i-ahmads/dual-sensor-seismic-alert-system/README.md

# Dual-Sensor Seismic Alert System

A prototype that combines a piezoelectric vibration sensor and an MPU-6050 accelerometer to trigger a local audible and visual alert. The project includes a breadboard firmware implementation, a separate FFT simulation path, circuit diagrams, Proteus simulation captures, and MATLAB signal analysis.

## Design overview

The intended architecture has a sensing node and an alarm/gateway node. The sensing node conditions the piezo signal, reads the accelerometer, and evaluates sensor agreement; the gateway design provides LEDs and a buzzer. The two PCB layouts were etched and drilled but are **unpopulated**. The demonstrated setup runs on **one breadboarded ESP32** with USB power.

| Path | What it does | Status |
|---|---|---|
| [RMS alarm firmware](firmware/Seismic_RMS_Alarm/Seismic_RMS_Alarm.ino) | Calibrates both sensors, evaluates RMS thresholds within a 500 ms agreement window, and latches the alarm | Breadboard demonstration |
| [FFT simulation firmware](firmware/Seismic_FFT_ProteusSim/Seismic_FFT_ProteusSim.ino) | 256 samples at 100 Hz, Hamming window, bins 3–25; simulated gateway confirmation | Proteus simulation on an Arduino Mega stand-in |
| [MATLAB validation](matlab/Seismic_FFT_Validation.m) | Compares in-band energy across earthquake and nuisance-vibration examples | Analysis script; original earthquake input file is not included |
| Two-node ESP-NOW and external event-feed cross-check | Communication and second-stage confirmation | Planned; not demonstrated |

### Hardware

Dual-sensor circuit overview

*Piezo and MPU-6050 sensing arrangement.*

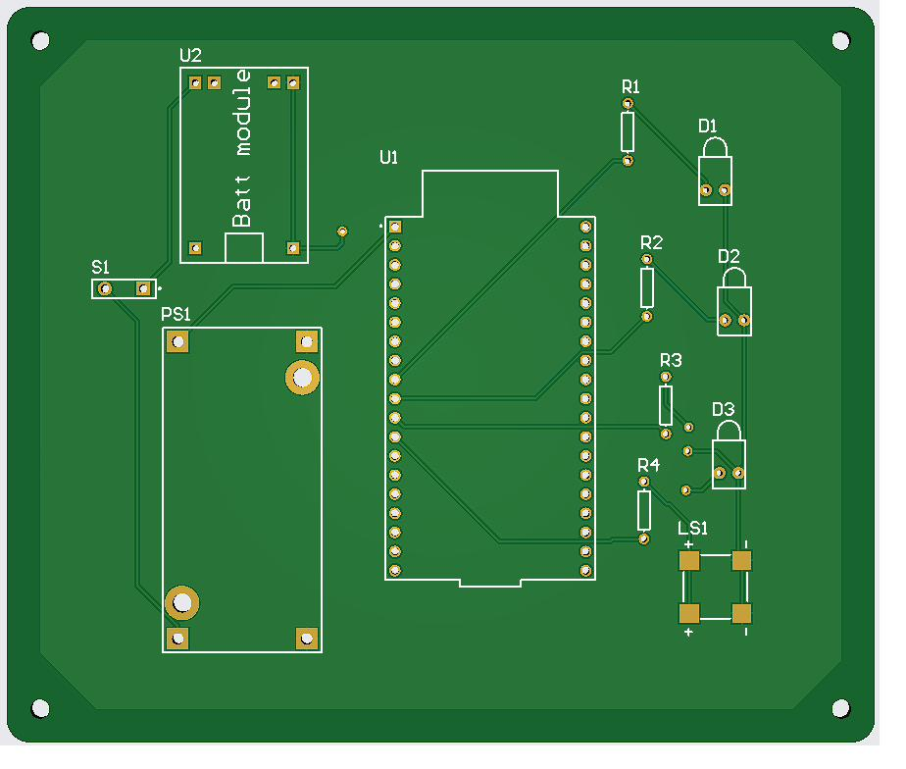
[picture p1: hardware/simulation/pcb_3d_preview.png]
3D preview of the sensing PCB layout


*Digital 3D preview of the proposed sensing board, with component placement. This is a CAD render, not a photograph of an assembled board.*

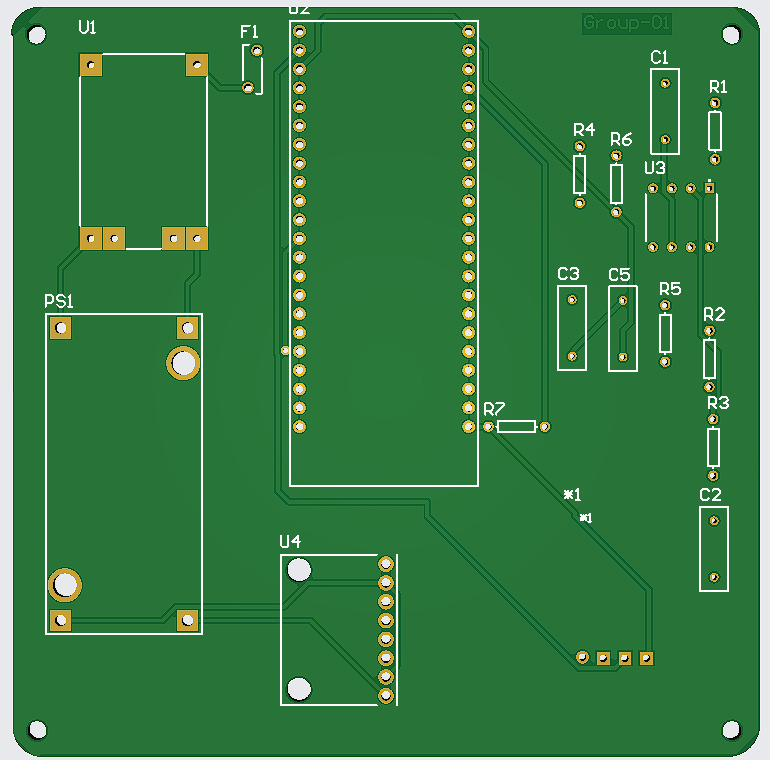
[picture p2: hardware/simulation/pcb_routing_preview.png]
Routed PCB design preview


*Routing preview for the same board. The separate [power](hardware/schematics/power_regulation.png), [ESP32 gateway](hardware/schematics/esp32_gateway.png), and [alarm indicator](hardware/schematics/alarm_indicator.png) diagrams cover other stages.*

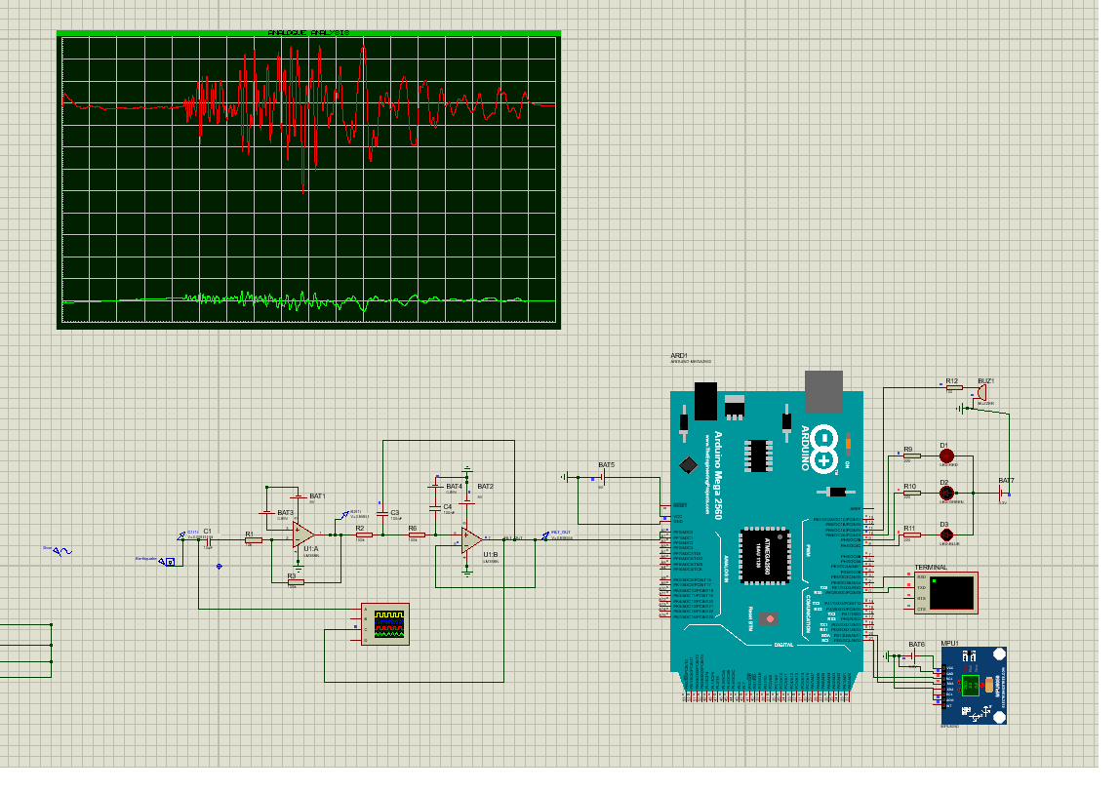
[picture p3: hardware/simulation/proteus_full_simulation.png]
Proteus circuit simulation with sensor and filter waveforms


*Proteus simulation of the filter, Arduino Mega stand-in, MPU-6050, and alarm outputs. A [closer waveform view](hardware/simulation/filter_output_waveform.png) shows the filter response; these are simulation captures, not measured breadboard traces.*

The [BOM](BOM.md) lists the main parts.

### Signal analysis

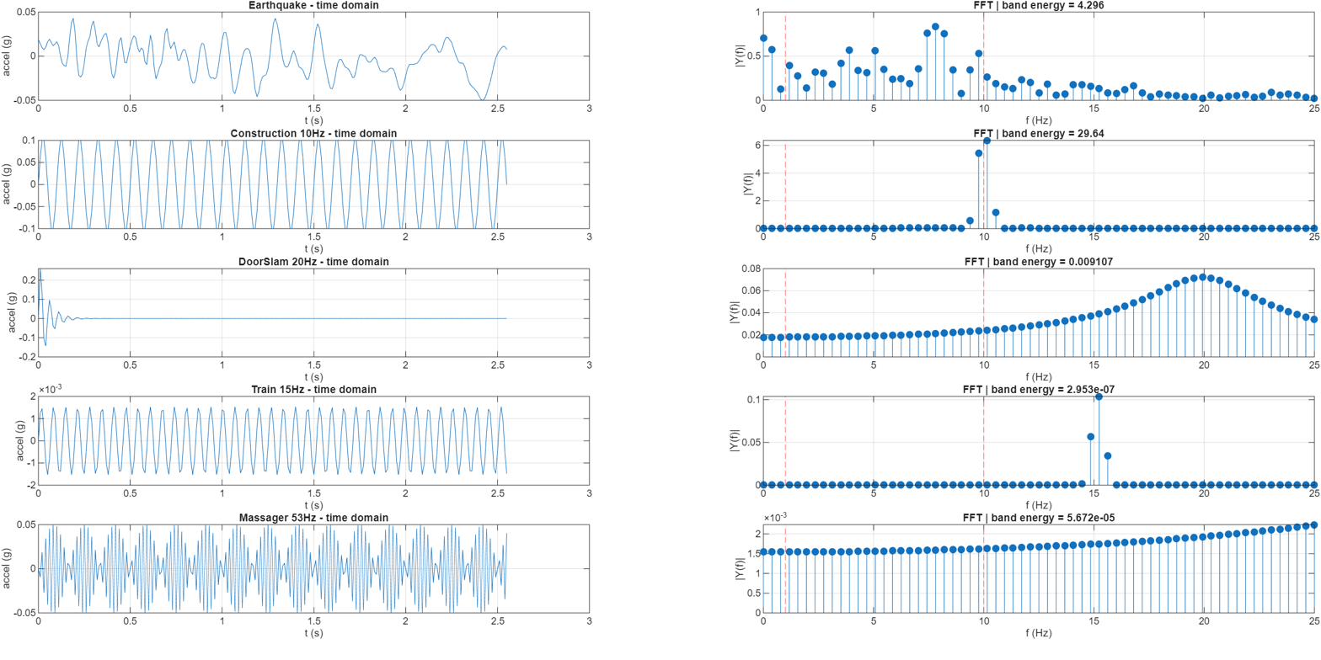
[picture p4: docs/figures/fft_signal_comparison.png]
Time-domain and FFT comparison of five vibration examples


*Saved MATLAB comparison figure. The 10 Hz construction example has more in-band energy than the earthquake example, illustrating why frequency content alone cannot decide whether an event is seismic. The raw earthquake sample used for the saved figure is absent from this repository; without `quake_signal.txt`, the MATLAB script substitutes a synthetic burst.*

## Known limitations

- The ESP-NOW link, populated two-board hardware, battery operation, and external event-feed confirmation remain untested or unimplemented.
- The LM2596 buck stage needs input headroom above a single-cell LiPo's 3.0–4.2 V range; the demonstrated setup used regulated USB power.
- The sensing board's F1 fuse footprint is not wired through a protective device in the documented revision. Do not treat it as fused.
- The piezo bias target was 0.889 V, but 0.22 V was measured during breadboard bring-up. This can clip negative-going samples; the firmware reports clipping but does not repair the hardware bias.
- The RMS firmware is separate from the FFT prototype. The archived signal figure and sketches do not establish real-world earthquake detection performance or provide a dependable public-warning system.

## Run the code

Open either `.ino` file from its matching sketch folder in Arduino IDE or `arduino-cli`:

- **RMS sketch:** ESP32 board package, `Adafruit MPU6050`, and `Adafruit Unified Sensor`. The sketch uses GPIO34 for piezo ADC input, default I2C for the MPU-6050, GPIO25/26/27 for LEDs, and GPIO14 for buzzer PWM. Check the exact ESP32 board's pin availability and voltage levels before wiring.
- **FFT sketch:** Arduino Mega 2560 stand-in used in Proteus; requires `arduinoFFT` v2. Its simulated confirmation timer is not an ESP-NOW implementation.
- **MATLAB script:** run `matlab/Seismic_FFT_Validation.m`. Supply an 850-sample `quake_signal.txt` in that directory to reproduce the archived earthquake-input analysis; otherwise the script uses its documented synthetic fallback.

## Repository contents

`firmware/` contains the two sketches; `matlab/` contains the FFT comparison script; `hardware/schematics/` has exported circuit figures; `hardware/simulation/` contains CAD previews and Proteus captures; `docs/figures/` contains the saved analysis figure. CAD project backups and identifying documents are outside this source-and-demonstration repository.
