i-ahmads/dual-sensor-seismic-alert-system/hardware/schematics/alarm_indicator.png

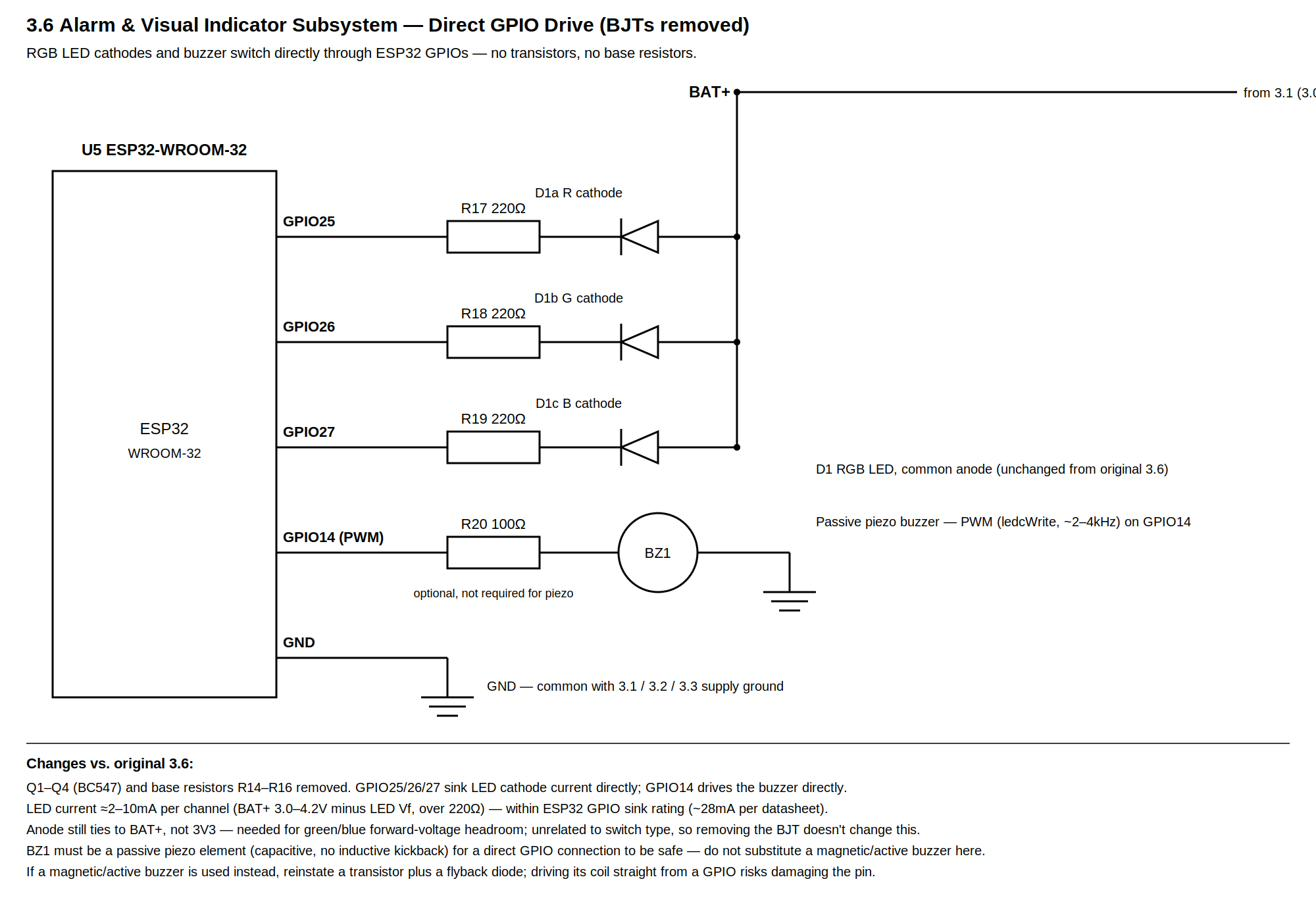
hardware/schematics/alarm_indicator.png
