i-ahmads/dual-sensor-seismic-alert-system/hardware/schematics/esp32_gateway.png

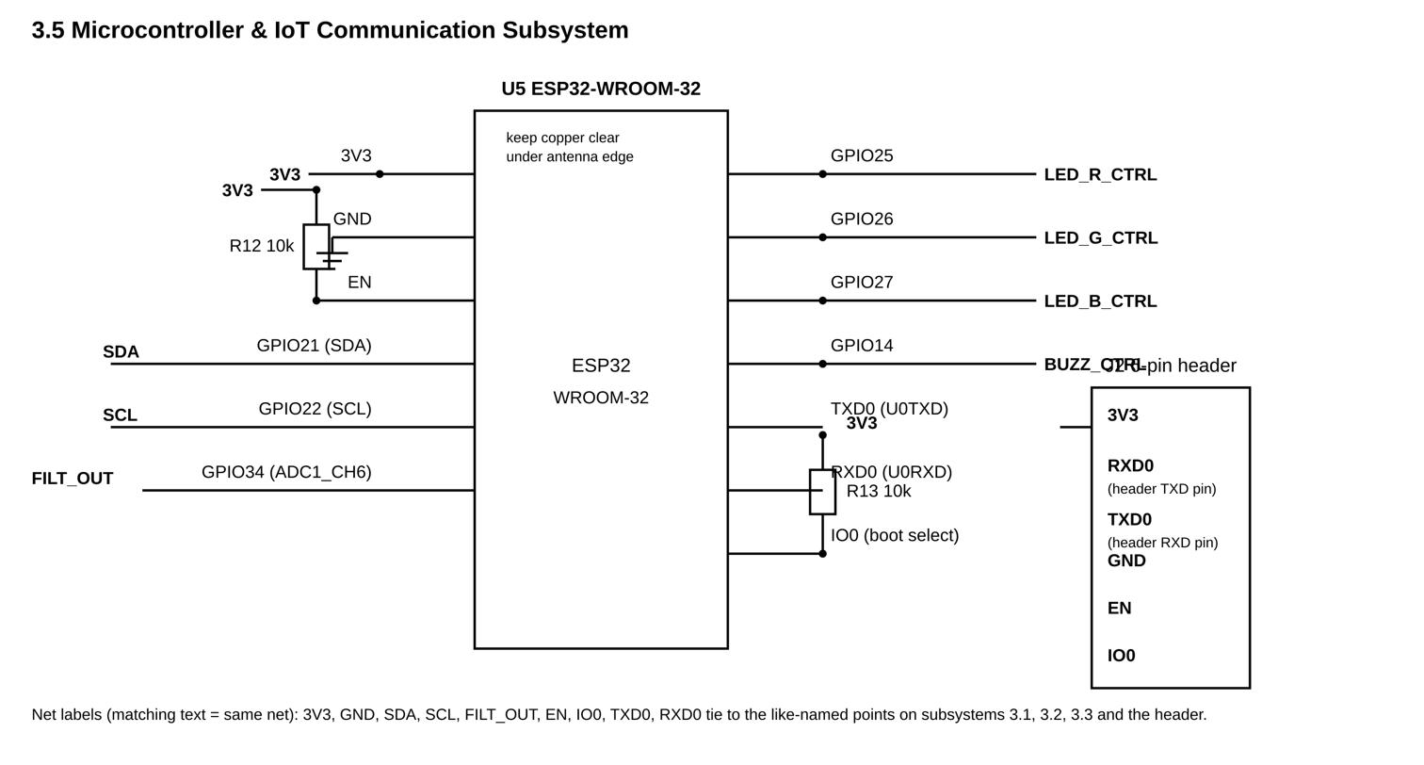
hardware/schematics/esp32_gateway.png
