i-ahmads/dual-sensor-seismic-alert-system/hardware/schematics/power_regulation.png

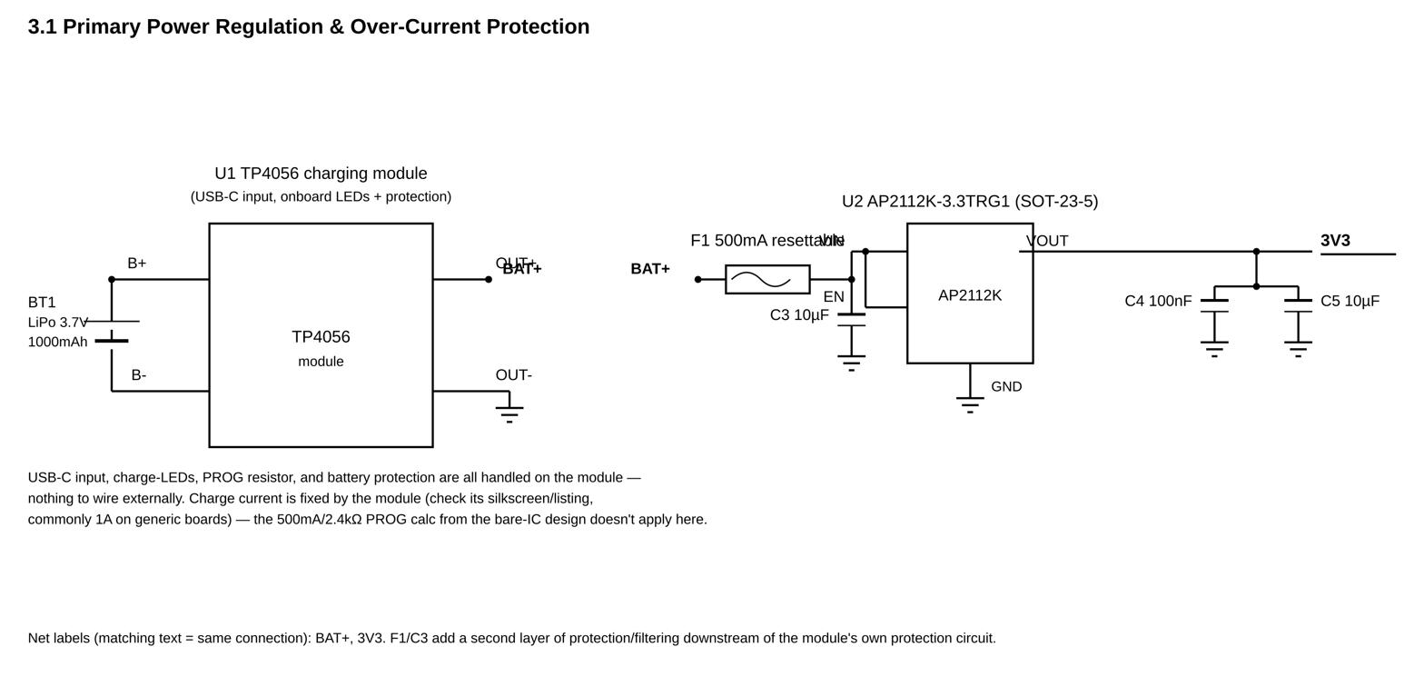
hardware/schematics/power_regulation.png
