i-ahmads/dual-sensor-seismic-alert-system/hardware/simulation/filter_output_waveform.png

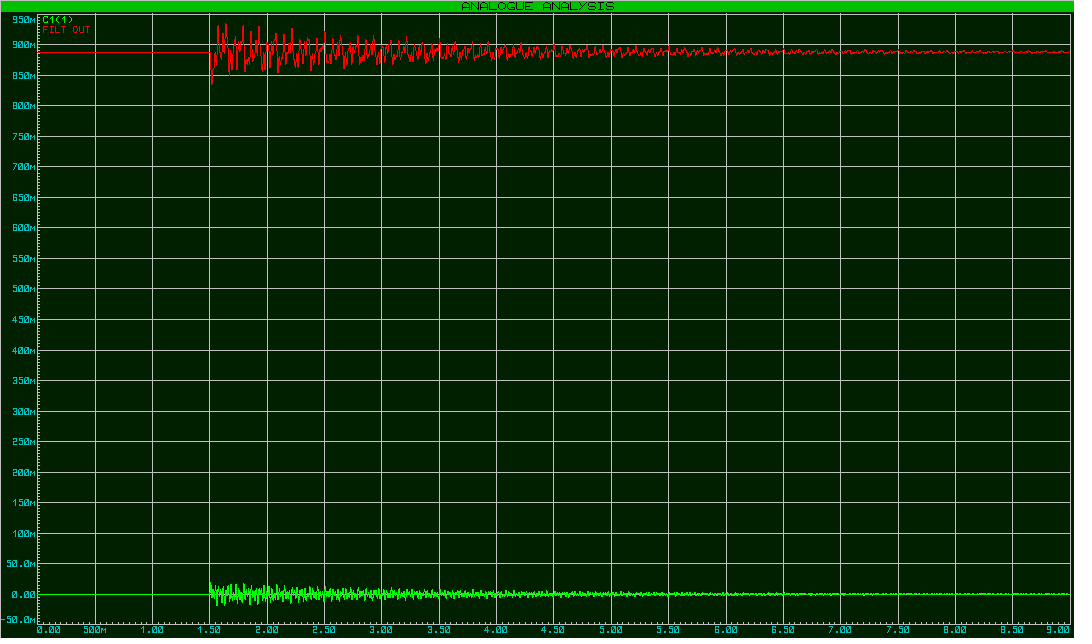
hardware/simulation/filter_output_waveform.png
