i-ahmads/dual-sensor-seismic-alert-system/(commit log)

2026-09-25 Publish seismic alert prototype source and visual documentation
2026-09-25 Show digital PCB and Proteus simulation previews in project overview
